TMaa-56/LNet-STOP-GO/README.md

LocoNet STOP en GO 

LocoNet STOP/GO schakeling als verlengstuk voor b.v. een Uhlenbrock Intellibox of iedere andere centrale met een 
LocoNet aansluiting (LocoNet – t) van de STOP en GO toetsen op deze centrale of via het besturingsprogramma. 
De schakeling kan met een 1 op 1 LocoNet compatible kabel aangesloten aan een centrale (Master), er worden 
alleen de Loconet (pin 3 en 4) en Ground (pin 2 en 5) aansluitingen gebruikt. De benodigde voeding van 5VDC dient 
separaat aangesloten te worden ! Dit is gedaan om de max. 500mA die de centrale kan leveren (volgens standaard) 
alleen te gebruiken voor direct spoor gerelateerde zaken zoals o.a. terugmelding en sturing. De 5VDC kan b.v. 
onttrokken worden van een 5VDC ringleiding welke ook voor diverse andere gebruikers is. (b.v. MobaLedLib) 
Het plaatsen van de componenten dient volgens schema (stuklijst) op de speciaal voor dit project gemaakte PCB, 
welke tevens een fraaie frontplaat is, in de hierna aangegeven volgorde voor een goede en juiste werking. De 
gebruikte componenten zijn hoofdzakelijk SMD (Surface Mount Device) onderdelen.
