TMaa-56/LNet-STOP-GO/(list of files, drawings)

Other design files:
LocoNet_STOP_GO_v10_TMaa.lay6
